TinyTapeout/tinytapeout-mpw7/spi/lvs/user_project_wrapper.spice

* NGSPICE file created from user_project_wrapper.ext - technology: sky130B

* Black-box entry subcircuit for scan_wrapper_341802448429515346 abstract view
.subckt scan_wrapper_341802448429515346 clk_in clk_out data_in data_out latch_enable_in
+ latch_enable_out scan_select_in scan_select_out vccd1 vssd1
.ends

* Black-box entry subcircuit for scan_wrapper_341262321634509394 abstract view
.subckt scan_wrapper_341262321634509394 clk_in clk_out data_in data_out latch_enable_in
+ latch_enable_out scan_select_in scan_select_out vccd1 vssd1
.ends

* Black-box entry subcircuit for scan_wrapper_341243232292700755 abstract view
.subckt scan_wrapper_341243232292700755 clk_in clk_out data_in data_out latch_enable_in
+ latch_enable_out scan_select_in scan_select_out vccd1 vssd1
.ends

* Black-box entry subcircuit for scan_wrapper_339501025136214612 abstract view
.subckt scan_wrapper_339501025136214612 clk_in clk_out data_in data_out latch_enable_in
+ latch_enable_out scan_select_in scan_select_out vccd1 vssd1
.ends

* Black-box entry subcircuit for scan_wrapper_1f985e14df1ed789231bb6e0189d6e39 abstract view
.subckt scan_wrapper_1f985e14df1ed789231bb6e0189d6e39 clk_in clk_out data_in data_out
+ latch_enable_in latch_enable_out scan_select_in scan_select_out vccd1 vssd1
.ends

* Black-box entry subcircuit for scan_wrapper_341524192738411090 abstract view
.subckt scan_wrapper_341524192738411090 clk_in clk_out data_in data_out latch_enable_in
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
.ends

* Black-box entry subcircuit for scan_wrapper_340218629792465491 abstract view
.subckt scan_wrapper_340218629792465491 clk_in clk_out data_in data_out latch_enable_in
+ latch_enable_out scan_select_in scan_select_out vccd1 vssd1
.ends

* Black-box entry subcircuit for scan_wrapper_341608297106768466 abstract view
.subckt scan_wrapper_341608297106768466 clk_in clk_out data_in data_out latch_enable_in
+ latch_enable_out scan_select_in scan_select_out vccd1 vssd1
.ends

* Black-box entry subcircuit for scan_wrapper_341569483755749970 abstract view
.subckt scan_wrapper_341569483755749970 clk_in clk_out data_in data_out latch_enable_in
+ latch_enable_out scan_select_in scan_select_out vccd1 vssd1
.ends

* Black-box entry subcircuit for scan_wrapper_341279123277087315 abstract view
.subckt scan_wrapper_341279123277087315 clk_in clk_out data_in data_out latch_enable_in
+ latch_enable_out scan_select_in scan_select_out vccd1 vssd1
.ends

* Black-box entry subcircuit for scan_wrapper_341353780122485332 abstract view
.subckt scan_wrapper_341353780122485332 clk_in clk_out data_in data_out latch_enable_in
+ latch_enable_out scan_select_in scan_select_out vccd1 vssd1
.ends

* Black-box entry subcircuit for scan_wrapper_341631644820570706 abstract view
.subckt scan_wrapper_341631644820570706 clk_in clk_out data_in data_out latch_enable_in
+ latch_enable_out scan_select_in scan_select_out vccd1 vssd1
.ends

* Black-box entry subcircuit for scan_wrapper_341624400621077076 abstract view
.subckt scan_wrapper_341624400621077076 clk_in clk_out data_in data_out latch_enable_in
+ latch_enable_out scan_select_in scan_select_out vccd1 vssd1
.ends
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
