TinyTapeout/tinytapeout-mpw7/verilog/gl/user_project_wrapper.v

module user_project_wrapper (user_clock2,
    vccd1,
    vccd2,
    vdda1,
    vdda2,
    vssa1,
    vssa2,
    vssd1,
    vssd2,
    wb_clk_i,
    wb_rst_i,
    wbs_ack_o,
    wbs_cyc_i,
    wbs_stb_i,
    wbs_we_i,
    analog_io,
    io_in,
    io_oeb,
    io_out,
    la_data_in,
    la_data_out,
    la_oenb,
    user_irq,
    wbs_adr_i,
    wbs_dat_i,
    wbs_dat_o,
    wbs_sel_i);
 input user_clock2;
 input vccd1;
 input vccd2;
 input vdda1;
 input vdda2;
 input vssa1;
 input vssa2;
 input vssd1;
 input vssd2;
 input wb_clk_i;
 input wb_rst_i;
 output wbs_ack_o;
 input wbs_cyc_i;
 input wbs_stb_i;
 input wbs_we_i;
 inout [28:0] analog_io;
 input [37:0] io_in;
 output [37:0] io_oeb;
 output [37:0] io_out;
 input [127:0] la_data_in;
 output [127:0] la_data_out;
 input [127:0] la_oenb;
 output [2:0] user_irq;
 input [31:0] wbs_adr_i;
 input [31:0] wbs_dat_i;
 output [31:0] wbs_dat_o;
 input [3:0] wbs_sel_i;

 wire \clk[0] ;
 wire \clk[100] ;
 wire \clk[101] ;
 wire \clk[102] ;
 wire \clk[103] ;
 wire \clk[104] ;
 wire \clk[105] ;
 wire \clk[106] ;
 wire \clk[107] ;
 wire \clk[108] ;
 wire \clk[109] ;
 wire \clk[10] ;
 wire \clk[110] ;
 wire \clk[111] ;
 wire \clk[112] ;
 wire \clk[113] ;
 wire \clk[114] ;
 wire \clk[115] ;
 wire \clk[116] ;
 wire \clk[117] ;
 wire \clk[118] ;
 wire \clk[119] ;
 wire \clk[11] ;
 wire \clk[120] ;
 wire \clk[121] ;
 wire \clk[122] ;
 wire \clk[123] ;
 wire \clk[124] ;
 wire \clk[125] ;
 wire \clk[126] ;
 wire \clk[127] ;
 wire \clk[128] ;
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
 wire \scan[86] ;
 wire \scan[87] ;
 wire \scan[88] ;
 wire \scan[89] ;
 wire \scan[8] ;
 wire \scan[90] ;
 wire \scan[91] ;
 wire \scan[92] ;
 wire \scan[93] ;
 wire \scan[94] ;
 wire \scan[95] ;
 wire \scan[96] ;
 wire \scan[97] ;
 wire \scan[98] ;
 wire \scan[99] ;
 wire \scan[9] ;

 scan_controller scan_controller (.clk(wb_clk_i),
    .la_scan_clk_in(la_data_in[0]),
    .la_scan_data_in(la_data_in[1]),
    .la_scan_data_out(la_data_out[0]),
    .la_scan_latch_en(la_data_in[3]),
    .la_scan_select(la_data_in[2]),
    .ready(io_out[37]),
    .reset(wb_rst_i),
    .scan_clk_in(\clk[498] ),
    .scan_clk_out(\clk[0] ),
    .scan_data_in(\data[498] ),
    .scan_data_out(\data[0] ),
    .scan_latch_en(\latch[0] ),
    .scan_select(\scan[0] ),
    .set_clk_div(io_in[11]),
    .slow_clk(io_out[10]),
    .vccd1(vccd1),
    .vssd1(vssd1),
    .active_select({io_in[20],
    io_in[19],
    io_in[18],
    io_in[17],
    io_in[16],
    io_in[15],
    io_in[14],
    io_in[13],
    io_in[12]}),
    .driver_sel({io_in[9],
    io_in[8]}),
    .inputs({io_in[28],
    io_in[27],
    io_in[26],
    io_in[25],
    io_in[24],
    io_in[23],
    io_in[22],
    io_in[21]}),
    .oeb({io_oeb[37],
    io_oeb[36],
    io_oeb[35],
    io_oeb[34],
    io_oeb[33],
    io_oeb[32],
    io_oeb[31],
    io_oeb[30],
    io_oeb[29],
    io_oeb[28],
    io_oeb[27],
    io_oeb[26],
    io_oeb[25],
    io_oeb[24],
    io_oeb[23],
    io_oeb[22],
    io_oeb[21],
    io_oeb[20],
    io_oeb[19],
    io_oeb[18],
    io_oeb[17],
    io_oeb[16],
    io_oeb[15],
    io_oeb[14],
    io_oeb[13],
    io_oeb[12],
    io_oeb[11],
    io_oeb[10],
    io_oeb[9],
    io_oeb[8],
    io_oeb[7],
    io_oeb[6],
    io_oeb[5],
    io_oeb[4],
    io_oeb[3],
    io_oeb[2],
    io_oeb[1],
    io_oeb[0]}),
    .outputs({io_out[36],
    io_out[35],
    io_out[34],
    io_out[33],
    io_out[32],
    io_out[31],
    io_out[30],
    io_out[29]}));
 scan_wrapper_019235602376235615 scan_wrapper_019235602376235615_77 (.clk_in(\clk[77] ),
    .clk_out(\clk[78] ),
    .data_in(\data[77] ),
    .data_out(\data[78] ),
    .latch_enable_in(\latch[77] ),
    .latch_enable_out(\latch[78] ),
    .scan_select_in(\scan[77] ),
    .scan_select_out(\scan[78] ),
    .vccd1(vccd1),
    .vssd1(vssd1));
 scan_wrapper_1f985e14df1ed789231bb6e0189d6e39 scan_wrapper_1f985e14df1ed789231bb6e0189d6e39_44 (.clk_in(\clk[44] ),
    .clk_out(\clk[45] ),
    .data_in(\data[44] ),
    .data_out(\data[45] ),
    .latch_enable_in(\latch[44] ),
    .latch_enable_out(\latch[45] ),
    .scan_select_in(\scan[44] ),
    .scan_select_out(\scan[45] ),
    .vccd1(vccd1),
    .vssd1(vssd1));
 scan_wrapper_339501025136214612 scan_wrapper_339501025136214612_0 (.clk_in(\clk[0] ),
    .clk_out(\clk[1] ),
    .data_in(\data[0] ),
    .data_out(\data[1] ),
    .latch_enable_in(\latch[0] ),
    .latch_enable_out(\latch[1] ),
    .scan_select_in(\scan[0] ),
    .scan_select_out(\scan[1] ),
    .vccd1(vccd1),
    .vssd1(vssd1));
 scan_wrapper_339501025136214612 scan_wrapper_339501025136214612_152 (.clk_in(\clk[152] ),
    .clk_out(\clk[153] ),
    .data_in(\data[152] ),
    .data_out(\data[153] ),
    .latch_enable_in(\latch[152] ),
    .latch_enable_out(\latch[153] ),
    .scan_select_in(\scan[152] ),
    .scan_select_out(\scan[153] ),
    .vccd1(vccd1),
    .vssd1(vssd1));
 scan_wrapper_339501025136214612 scan_wrapper_339501025136214612_153 (.clk_in(\clk[153] ),
    .clk_out(\clk[154] ),
    .data_in(\data[153] ),
    .data_out(\data[154] ),
    .latch_enable_in(\latch[153] ),
    .latch_enable_out(\latch[154] ),
    .scan_select_in(\scan[153] ),
    .scan_select_out(\scan[154] ),
    .vccd1(vccd1),
    .vssd1(vssd1));
 scan_wrapper_339501025136214612 scan_wrapper_339501025136214612_154 (.clk_in(\clk[154] ),
    .clk_out(\clk[155] ),
    .data_in(\data[154] ),
    .data_out(\data[155] ),
    .latch_enable_in(\latch[154] ),
    .latch_enable_out(\latch[155] ),
    .scan_select_in(\scan[154] ),
    .scan_select_out(\scan[155] ),
    .vccd1(vccd1),
    .vssd1(vssd1));
 scan_wrapper_339501025136214612 scan_wrapper_339501025136214612_155 (.clk_in(\clk[155] ),
    .clk_out(\clk[156] ),
    .data_in(\data[155] ),
    .data_out(\data[156] ),
    .latch_enable_in(\latch[155] ),
    .latch_enable_out(\latch[156] ),
    .scan_select_in(\scan[155] ),
    .scan_select_out(\scan[156] ),
    .vccd1(vccd1),
    .vssd1(vssd1));
 scan_wrapper_339501025136214612 scan_wrapper_339501025136214612_156 (.clk_in(\clk[156] ),
    .clk_out(\clk[157] ),
    .data_in(\data[156] ),
    .data_out(\data[157] ),
    .latch_enable_in(\latch[156] ),
    .latch_enable_out(\latch[157] ),
    .scan_select_in(\scan[156] ),
    .scan_select_out(\scan[157] ),
    .vccd1(vccd1),
    .vssd1(vssd1));
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
    .latch_enable_out(\latch[372] ),
    .scan_select_in(\scan[371] ),
    .scan_select_out(\scan[372] ),
    .vccd1(vccd1),
    .vssd1(vssd1));
 scan_wrapper_339501025136214612 scan_wrapper_339501025136214612_372 (.clk_in(\clk[372] ),
    .clk_out(\clk[373] ),
    .data_in(\data[372] ),
    .data_out(\data[373] ),
    .latch_enable_in(\latch[372] ),
    .latch_enable_out(\latch[373] ),
    .scan_select_in(\scan[372] ),
    .scan_select_out(\scan[373] ),
    .vccd1(vccd1),
    .vssd1(vssd1));
 scan_wrapper_339501025136214612 scan_wrapper_339501025136214612_373 (.clk_in(\clk[373] ),
    .clk_out(\clk[374] ),
    .data_in(\data[373] ),
    .data_out(\data[374] ),
    .latch_enable_in(\latch[373] ),
    .latch_enable_out(\latch[374] ),
    .scan_select_in(\scan[373] ),
    .scan_select_out(\scan[374] ),
    .vccd1(vccd1),
    .vssd1(vssd1));
 scan_wrapper_339501025136214612 scan_wrapper_339501025136214612_374 (.clk_in(\clk[374] ),
    .clk_out(\clk[375] ),
    .data_in(\data[374] ),
    .data_out(\data[375] ),
    .latch_enable_in(\latch[374] ),
    .latch_enable_out(\latch[375] ),
    .scan_select_in(\scan[374] ),
    .scan_select_out(\scan[375] ),
    .vccd1(vccd1),
    .vssd1(vssd1));
 scan_wrapper_339501025136214612 scan_wrapper_339501025136214612_375 (.clk_in(\clk[375] ),
    .clk_out(\clk[376] ),
    .data_in(\data[375] ),
    .data_out(\data[376] ),
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
