TinyTapeout/tinytapeout-mpw7/verilog/rtl/user_module_341717091617866324.v

`default_nettype none

module utm_core_341717091617866324(
    input clock,
    input reset,
    input mode,
    input [2:0] encoded_state_in,
    input [2:0] sym_in,
    input sym_in_valid,
    output [2:0] new_sym,
    output direction,
    output [2:0] encoded_next_state
);

reg [7:0] stored_state;
reg [2:0] symbuf;
reg symbuf_valid;

wire [7:0] state_in;
wire [7:0] state;
wire [7:0] next_state;
wire [2:0] sym;

always @(posedge clock) begin
    if (reset) begin
        stored_state <= 8'h01;
    end
    else if (sym_in_valid && symbuf_valid) begin
        stored_state <= next_state;
    end
    else begin
        stored_state <= stored_state;
    end
end

always @(posedge clock) begin
    if (reset) begin
        symbuf <= 3'b0;
    end
    else if (sym_in_valid) begin
        symbuf <= sym_in;
    end
    else begin
        symbuf <= symbuf;
    end
end

always @(posedge clock) begin
    if (reset) begin
        symbuf_valid <= 0;
    end
    else if (sym_in_valid) begin
        symbuf_valid <= 1;
    end
    else begin
        symbuf_valid <= symbuf_valid;
    end
end

decoder_3to8_341717091617866324 decode_state_in(
    .in(encoded_state_in),
    .out(state_in)
);

assign state = (mode == 0) ? state_in : stored_state;
assign sym = (mode == 0) ? sym_in : symbuf;

direction_341717091617866324 direction_block(
    .state(state),
    .s2(sym[2]),
    .s1(sym[1]),
    .s0(sym[0]),
    .direction(direction)
);

next_state_341717091617866324 next_state_block(
    .state_in(state),
    .s2(sym[2]),
    .s1(sym[1]),
    .s0(sym[0]),
    .state_out(next_state));

new_symbol_341717091617866324 new_sym_block(
    .state_in(state),
    .s2(sym[2]),
    .s1(sym[1]),
    .s0(sym[0]),
    .z2(new_sym[2]),
    .z1(new_sym[1]),
    .z0(new_sym[0])
);

encoder_8to3_341717091617866324 encode_state_out(
    .in(next_state),
    .out(encoded_next_state)
);

endmodule
`default_nettype none
module direction_341717091617866324(
    input [7:0] state,
    input s2,
    input s1,
    input s0,
    // 0 = left, 1 = right
    output direction
);

wire [7:0] state_in;
assign state_in = state;

wire [2:0] sym_in;
assign sym_in = {s2, s1, s0};

reg dir;
assign direction = dir;

always @(*) begin
    /* verilator lint_off CASEINCOMPLETE */
    case (state_in)
        8'h01: begin
            case (sym_in)
            3'b000: begin
                dir = 0;
            end
            3'b001: begin
                dir = 0;
            end
            3'b010: begin
                dir = 1;
            end
            3'b100: begin
                dir = 0;
            end
            3'b101: begin
                dir = 1;
            end
            3'b110: begin
                dir = 1;
            end
            3'b111: begin
                dir = 1;
            end
            endcase
        end
        8'h02: begin
            case (sym_in)
            3'b000: begin
                dir = 0;
            end
            3'b001: begin
                dir = 0;
            end
            3'b010: begin
                dir = 0;
            end
            3'b100: begin
                dir = 1;
            end
            3'b101: begin
                dir = 1;
            end
            3'b110: begin
                dir = 0;
            end
            3'b111: begin
                dir = 0;
            end
            endcase
        end
        8'h04: begin
            case (sym_in)
            3'b000: begin
                dir = 0;
            end
            3'b001: begin
                dir = 0;
            end
            3'b010: begin
                dir = 0;
            end
            3'b100: begin
                dir = 1;
            end
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
assign out[4] = ( in[2]) & (~in[1]) & (~in[0]);
assign out[5] = ( in[2]) & (~in[1]) & ( in[0]);
assign out[6] = ( in[2]) & ( in[1]) & (~in[0]);
assign out[7] = ( in[2]) & ( in[1]) & ( in[0]);

endmodule
module encoder_8to3_341717091617866324(
    input [7:0] in,
    output [2:0] out
);

assign out[0] = in[1] | in[3] | in[5] | in[7];
assign out[1] = in[2] | in[3] | in[6] | in[7];
assign out[2] = in[4] | in[5] | in[6] | in[7];
endmodule
`default_nettype none

module user_module_341717091617866324(
  input [7:0] io_in,
  output [7:0] io_out
);

wire mode;
wire clock;
wire reset;

wire direction;

wire sym_valid;
wire [2:0] sym_in;
wire [2:0] new_sym;

// 1-hot state in & out
wire [7:0] state_in;
wire [7:0] state_out;

// 3-bit dense encoding of state in & out
wire [2:0] encoded_state_in;
wire [2:0] encoded_state_out;

assign mode = io_in[7];
assign clock = io_in[0];
assign reset = (mode == 0) ? 1'b1 : io_in[1];

assign encoded_state_in = (mode == 0) ? io_in[3:1] : 3'b0;
assign io_out[7:5] = encoded_state_out;

assign sym_valid = (mode == 0) ? 1'b0 : io_in[2];
assign sym_in = io_in[6:4];
assign io_out[4:2] = new_sym;

assign io_out[1] = direction;
assign io_out[0] = 1'b0;

utm_core_341717091617866324 core(
    .clock(clock),
    .reset(reset),
    .mode(mode),
    .encoded_state_in(encoded_state_in),
    .sym_in(sym_in),
    .sym_in_valid(sym_valid),
    .new_sym(new_sym),
    .direction(direction),
    .encoded_next_state(encoded_state_out)
);

endmodule
