TinyTapeout/tinytapeout-mpw7/verilog/rtl/user_project_wrapper.v

// SPDX-FileCopyrightText: 2020 Efabless Corporation
//
// Licensed under the Apache License, Version 2.0 (the "License");
// you may not use this file except in compliance with the License.
// You may obtain a copy of the License at
//
//      http://www.apache.org/licenses/LICENSE-2.0
//
// Unless required by applicable law or agreed to in writing, software
// distributed under the License is distributed on an "AS IS" BASIS,
// WITHOUT WARRANTIES OR CONDITIONS OF ANY KIND, either express or implied.
// See the License for the specific language governing permissions and
// limitations under the License.
// SPDX-License-Identifier: Apache-2.0

`default_nettype none
/*
 *-------------------------------------------------------------
 *
 * user_project_wrapper
 *
 * This wrapper enumerates all of the pins available to the
 * user for the user project.
 *
 * An example user project is provided in this wrapper.  The
 * example should be removed and replaced with the actual
 * user project.
 *
 * THIS FILE HAS BEEN GENERATED USING multi_tools_project CODEGEN
 * IF YOU NEED TO MAKE EDITS TO IT, EDIT codegen/caravel_iface_header.txt
 *
 *-------------------------------------------------------------
 */

module user_project_wrapper #(
    parameter BITS = 32
)(
`ifdef USE_POWER_PINS
    inout vdda1,       // User area 1 3.3V supply
    inout vdda2,       // User area 2 3.3V supply
    inout vssa1,       // User area 1 analog ground
    inout vssa2,       // User area 2 analog ground
    inout vccd1,       // User area 1 1.8V supply
    inout vccd2,       // User area 2 1.8v supply
    inout vssd1,       // User area 1 digital ground
    inout vssd2,       // User area 2 digital ground
`endif

    // Wishbone Slave ports (WB MI A)
    input wb_clk_i,
    input wb_rst_i,
    input wbs_stb_i,
    input wbs_cyc_i,
    input wbs_we_i,
    input [3:0] wbs_sel_i,
    input [31:0] wbs_dat_i,
    input [31:0] wbs_adr_i,
    output wbs_ack_o,
    output [31:0] wbs_dat_o,

    // Logic Analyzer Signals
    input  [127:0] la_data_in,
    output [127:0] la_data_out,
    input  [127:0] la_oenb,

    // IOs
    input  [`MPRJ_IO_PADS-1:0] io_in,
    output [`MPRJ_IO_PADS-1:0] io_out,
    output [`MPRJ_IO_PADS-1:0] io_oeb,

    // Analog (direct connection to GPIO pad---use with caution)
    // Note that analog I/O is not available on the 7 lowest-numbered
    // GPIO pads, and so the analog_io indexing is offset from the
    // GPIO indexing by 7 (also upper 2 GPIOs do not have analog_io).
    inout [`MPRJ_IO_PADS-10:0] analog_io,

    // Independent clock (on independent integer divider)
    input   user_clock2,

    // User maskable interrupt signals
    output [2:0] user_irq
);

    // start of module instantiation

        localparam NUM_MACROS = 498;
        wire [NUM_MACROS:0] data, scan, latch, clk;
        
        scan_controller #(.NUM_DESIGNS(NUM_MACROS)) scan_controller(
            .clk                    (wb_clk_i),
            .reset                  (wb_rst_i),
            .active_select          (io_in[20:12]),
            .inputs                 (io_in[28:21]),
            .outputs                (io_out[36:29]),
            .ready                  (io_out[37]),
            .slow_clk               (io_out[10]),
            .set_clk_div            (io_in[11]),

            .scan_clk_out           (clk[0]),
            .scan_clk_in            (clk[NUM_MACROS]),
            .scan_data_out          (data[0]),
            .scan_data_in           (data[NUM_MACROS]),
            .scan_select            (scan[0]),
            .scan_latch_en          (latch[0]),

            .la_scan_clk_in         (la_data_in[0]),
            .la_scan_data_in        (la_data_in[1]),
            .la_scan_data_out       (la_data_out[0]),
            .la_scan_select         (la_data_in[2]),
            .la_scan_latch_en       (la_data_in[3]),

            .driver_sel             (io_in[9:8]),

            .oeb                    (io_oeb)
        );

        
        // https://github.com/mattvenn/wokwi_filler
        scan_wrapper_339501025136214612 #(.NUM_IOS(8)) scan_wrapper_339501025136214612_0 (
            .clk_in          (clk  [0]),
            .data_in         (data [0]),
            .scan_select_in  (scan [0]),
            .latch_enable_in (latch[0]),
            .clk_out         (clk  [1]),
            .data_out        (data [1]),
            .scan_select_out (scan [1]),
            .latch_enable_out(latch[1])
            );
        
        // https://github.com/mattvenn/tinytapeout_m_segments
        scan_wrapper_339688086163161683 #(.NUM_IOS(8)) scan_wrapper_339688086163161683_1 (
            .clk_in          (clk  [1]),
            .data_in         (data [1]),
            .scan_select_in  (scan [1]),
            .latch_enable_in (latch[1]),
            .clk_out         (clk  [2]),
            .data_out        (data [2]),
            .scan_select_out (scan [2]),
            .latch_enable_out(latch[2])
            );
        
        // https://github.com/gregdavill/tinytapeout_spin0
        scan_wrapper_340218629792465491 #(.NUM_IOS(8)) scan_wrapper_340218629792465491_2 (
            .clk_in          (clk  [2]),
            .data_in         (data [2]),
            .scan_select_in  (scan [2]),
            .latch_enable_in (latch[2]),
            .clk_out         (clk  [3]),
            .data_out        (data [3]),
            .scan_select_out (scan [3]),
            .latch_enable_out(latch[3])
            );
        
        // https://github.com/mole99/wokwi-1bit-alu
        scan_wrapper_340318610245288530 #(.NUM_IOS(8)) scan_wrapper_340318610245288530_3 (
            .clk_in          (clk  [3]),
            .data_in         (data [3]),
            .scan_select_in  (scan [3]),
            .latch_enable_in (latch[3]),
            .clk_out         (clk  [4]),
            .data_out        (data [4]),
            .scan_select_out (scan [4]),
            .latch_enable_out(latch[4])
            );
        
        // https://github.com/ericsmi/tinytapeout_popcnt.git
        scan_wrapper_340285391309374034 #(.NUM_IOS(8)) scan_wrapper_340285391309374034_4 (
            .clk_in          (clk  [4]),
            .data_in         (data [4]),
            .scan_select_in  (scan [4]),
            .latch_enable_in (latch[4]),
            .clk_out         (clk  [5]),
            .data_out        (data [5]),
            .scan_select_out (scan [5]),
            .latch_enable_out(latch[5])
            );
        
        // https://github.com/krasin/wokwi-guess-my-number
        scan_wrapper_340661930553246290 #(.NUM_IOS(8)) scan_wrapper_340661930553246290_5 (
            .clk_in          (clk  [5]),
            .data_in         (data [5]),
            .scan_select_in  (scan [5]),
            .latch_enable_in (latch[5]),
            .clk_out         (clk  [6]),
            .data_out        (data [6]),
            .scan_select_out (scan [6]),
            .latch_enable_out(latch[6])
            );
        
        // https://github.com/johshoff/barrelshifter-wokwi-gds
        scan_wrapper_341136771628663380 #(.NUM_IOS(8)) scan_wrapper_341136771628663380_6 (
            .clk_in          (clk  [6]),
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
            .latch_enable_in (latch[222]),
            .clk_out         (clk  [223]),
            .data_out        (data [223]),
            .scan_select_out (scan [223]),
            .latch_enable_out(latch[223])
            );
        
        // https://github.com/mattvenn/wokwi_filler
        scan_wrapper_339501025136214612 #(.NUM_IOS(8)) scan_wrapper_339501025136214612_223 (
            .clk_in          (clk  [223]),
            .data_in         (data [223]),
            .scan_select_in  (scan [223]),
            .latch_enable_in (latch[223]),
            .clk_out         (clk  [224]),
            .data_out        (data [224]),
            .scan_select_out (scan [224]),
            .latch_enable_out(latch[224])
            );
        
        // https://github.com/mattvenn/wokwi_filler
        scan_wrapper_339501025136214612 #(.NUM_IOS(8)) scan_wrapper_339501025136214612_224 (
            .clk_in          (clk  [224]),
            .data_in         (data [224]),
            .scan_select_in  (scan [224]),
            .latch_enable_in (latch[224]),
            .clk_out         (clk  [225]),
            .data_out        (data [225]),
            .scan_select_out (scan [225]),
            .latch_enable_out(latch[225])
            );
        
        // https://github.com/mattvenn/wokwi_filler
        scan_wrapper_339501025136214612 #(.NUM_IOS(8)) scan_wrapper_339501025136214612_225 (
            .clk_in          (clk  [225]),
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
