TinyTapeout/tinytapeout-mpw7/verilog/rtl/user_module_341542971476279892.v

`default_nettype none

//  Top level io for this module should stay the same to fit into the scan_wrapper.
//  The pin connections within the user_module are up to you,
//  although (if one is present) it is recommended to place a clock on io_in[0].
//  This allows use of the internal clock divider if you wish.
module user_module_341542971476279892(
  input [7:0] io_in, 
  output [7:0] io_out
);

  logo_341542971476279892 logo(
    .clk(io_in[0]),    
    .reset(io_in[1]),

    .tx_out(io_out[0])
  );

endmodule

//  Any submodules should be included in this file,
//  so they are copied into the main TinyTapeout repo.
//  Appending your ID to any submodules you create 
//  ensures there are no clashes in full-chip simulation.

module logo_341542971476279892 (
    input clk,
    input reset,
    
    output reg tx_out
  );

  reg       [7:0] rle_segment_counter;
  reg       [7:0] rle_pixel_counter;
  reg             rle_pixel_state;

  reg       [7:0] line_pixel_counter; //0 to IMG_WIDTH-1, pixels within a line

  reg       [7:0] next_rle_segment_counter;
  reg       [7:0] next_rle_pixel_counter;
  reg             next_rle_pixel_state;

  reg       [7:0] next_line_pixel_counter;

  reg       [7:0] current_rle_length; //length of current segment
  reg       [7:0] current_rle_n_segments; //number of segments in image
  
  reg             start_pixel;
  reg       [7:0] img_width; //max 255 with 8 bits

  //picture data

  parameter LEN_lambdaRLE = 207;
  parameter WIDTH_lambdaRLE = 41;
  parameter START_lambdaRLE = 1;
  wire [7:0] lambdaRLE [0:LEN_lambdaRLE-1]; //Lambda symbol
  
  assign lambdaRLE[0] = 41; assign lambdaRLE[1] = 136; assign lambdaRLE[2] = 3; assign lambdaRLE[3] = 9; assign lambdaRLE[4] = 3; assign lambdaRLE[5] = 26; assign lambdaRLE[6] = 3; assign lambdaRLE[7] = 9; assign lambdaRLE[8] = 3; assign lambdaRLE[9] = 26; assign lambdaRLE[10] = 3; assign lambdaRLE[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

  always @(posedge clk) begin
    if (reset) begin
      rle_segment_counter <= 0;
      rle_pixel_counter   <= 0;
      rle_pixel_state     <= start_pixel;

      line_pixel_counter  <= 0;
    end else begin
      rle_segment_counter <= next_rle_segment_counter;
      rle_pixel_counter <= next_rle_pixel_counter;
      rle_pixel_state <= next_rle_pixel_state;

      line_pixel_counter <= next_line_pixel_counter;
    end
  end

  always @(*) begin
    next_rle_segment_counter = rle_segment_counter;
    next_rle_pixel_counter = rle_pixel_counter;
    next_rle_pixel_state = rle_pixel_state;

    next_line_pixel_counter = line_pixel_counter;

    current_rle_length     = lambdaRLE[rle_segment_counter];
    current_rle_n_segments = LEN_lambdaRLE;
    start_pixel = START_lambdaRLE;
    img_width = WIDTH_lambdaRLE;
    
    if(rle_pixel_counter < current_rle_length-1) begin
      next_rle_pixel_counter = rle_pixel_counter + 1;
    end else begin
      next_rle_pixel_counter = 0;
      next_rle_pixel_state = !rle_pixel_state;

      if(rle_segment_counter < current_rle_n_segments-1) begin
        next_rle_segment_counter = rle_segment_counter + 1;
      end else begin
        next_rle_segment_counter = 0;
        next_rle_pixel_state = start_pixel;
        next_line_pixel_counter = 0;
      end
    end

    tx_out = rle_pixel_state;
  end


endmodule
