TinyTapeout/tinytapeout-mpw7/verilog/rtl/user_project_includes.v

`include "scan_controller/scan_controller.v"
`include "scan_wrapper_339501025136214612.v"
`include "scan_wrapper_339688086163161683.v"
`include "scan_wrapper_340218629792465491.v"
`include "scan_wrapper_340318610245288530.v"
`include "scan_wrapper_340285391309374034.v"
`include "scan_wrapper_340661930553246290.v"
`include "scan_wrapper_341136771628663380.v"
`include "scan_wrapper_339800239192932947.v"
`include "scan_wrapper_341154161238213203.v"
`include "scan_wrapper_341159915403870803.v"
`include "scan_wrapper_341154068332282450.v"
`include "scan_wrapper_341160201697624660.v"
`include "scan_wrapper_341163800289870419.v"
`include "scan_wrapper_341160271679586899.v"
`include "scan_wrapper_341161378978988626.v"
`include "scan_wrapper_341152580068442706.v"
`include "scan_wrapper_341155178824598098.v"
`include "scan_wrapper_341167691532337747.v"
`include "scan_wrapper_341178154799333971.v"
`include "scan_wrapper_341178481588044372.v"
`include "scan_wrapper_341176884318437971.v"
`include "scan_wrapper_341182944314917460.v"
`include "scan_wrapper_341188777753969234.v"
`include "scan_wrapper_341194143598379604.v"
`include "scan_wrapper_341205508016833108.v"
`include "scan_wrapper_341162950004834900.v"
`include "scan_wrapper_341202178192441940.v"
`include "scan_wrapper_341191836498395731.v"
`include "scan_wrapper_341192113929585235.v"
`include "scan_wrapper_341192621088047698.v"
`include "scan_wrapper_340579111348994642.v"
`include "scan_wrapper_341224613878956628.v"
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
`include "scan_wrapper_341490465660469844.v"
`include "scan_wrapper_341581732833657427.v"
`include "scan_wrapper_341457494561784402.v"
`include "scan_wrapper_341590933015364178.v"
`include "scan_wrapper_341589685194195540.v"
`include "scan_wrapper_341608574336631379.v"
`include "scan_wrapper_341608297106768466.v"
`include "scan_wrapper_341802448429515346.v"
`include "scan_wrapper_341609034095264340.v"
`include "scan_wrapper_341617722294010450.v"
`include "scan_wrapper_341613097060926036.v"
`include "scan_wrapper_341614346808328788.v"
`include "scan_wrapper_341620484740219475.v"
`include "scan_wrapper_341624400621077076.v"
`include "scan_wrapper_341614536664547922.v"
`include "scan_wrapper_341567111632519764.v"
`include "scan_wrapper_3398002391929329472.v"
`include "scan_wrapper_341631485498884690.v"
`include "scan_wrapper_341632596577354323.v"
`include "scan_wrapper_341628725785264722.v"
`include "scan_wrapper_341631511790879314.v"
`include "scan_wrapper_341426151397261906.v"
`include "scan_wrapper_341629415144292948.v"
`include "scan_wrapper_341637831098106450.v"
`include "scan_wrapper_341631644820570706.v"
`include "scan_wrapper_340596276030603858.v"
`include "scan_wrapper_341678527574180436.v"
