TinyTapeout/tinytapeout-mpw7/verilog/rtl/user_module_1f985e14df1ed789231bb6e0189d6e39.v

module s_p_shift_reg #(parameter LENGTH=256, parameter ROT_LEN = 8) (input d,
                                          input clk,
                                          input rst_n,
                                          input cs_n,
                                          input rot_n,
                                          output reg [LENGTH-1:0] out);
                                                      
  always @(posedge clk or negedge rst_n)
    begin
      if(!rst_n)
        out <= {LENGTH{1'b0}};
      else if (!cs_n)
        out <= {out[LENGTH-2:0], d};
      else if (!rot_n)
        out <= {out[ROT_LEN -1:0], out[LENGTH -1:ROT_LEN]};
      else 
        out <= out;
    end
  
endmodule

module lut #(parameter IN_WIDTH=4, parameter OUT_WIDTH=4) (input [IN_WIDTH-1:0] sel,
                                                           input [2**(IN_WIDTH)*OUT_WIDTH-1:0] in,
                                                           output [OUT_WIDTH-1:0] out);
 
 
  
  wire [OUT_WIDTH-1:0] chunked_in [2**IN_WIDTH-1:0];
  
  genvar i;
  
  generate
    for (i = 0; i < 2**IN_WIDTH; i = i+1) begin
      assign chunked_in[i] = in[(i+1) * OUT_WIDTH - 1 -: OUT_WIDTH];
    end
  endgenerate	     
  
  assign out = chunked_in[sel];
  
endmodule

module serial_load_lut #(parameter IN_WIDTH=4, parameter OUT_WIDTH=4, parameter ROT_LEN=8) (
  input d, input clk, input rst_n, input cs_n, input rot_n, input [IN_WIDTH-1:0] sel, output [OUT_WIDTH-1:0] out);
  
  wire [2**(IN_WIDTH)*OUT_WIDTH-1:0] parallel_table;
  
  s_p_shift_reg #(2**(IN_WIDTH)*OUT_WIDTH, ROT_LEN) p_s_shift_reg(.d(d),.clk(clk),.rst_n(rst_n),.cs_n(cs_n),
                                                                  .rot_n(rot_n), .out(parallel_table));
  
  lut #(IN_WIDTH, OUT_WIDTH) lut(.sel(sel), .in(parallel_table), .out(out));
  
  
endmodule

module user_module_1f985e14df1ed789231bb6e0189d6e39(
  input [7:0] io_in,
  output [7:0] io_out
);

  serial_load_lut #(2, 8) lut(.d(io_in[0]), .clk(io_in[1]), .rst_n(io_in[2]), .cs_n(io_in[3]), 
                              .rot_n(io_in[6]), .sel(io_in[5:4]), .out(io_out[7:0]));
  
  //assign io_out[7:3] = 0;
  
endmodule
