TinyTapeout/tinytapeout-mpw7/verilog/gl/scan_controller.v

module scan_controller (clk,
    la_scan_clk_in,
    la_scan_data_in,
    la_scan_data_out,
    la_scan_latch_en,
    la_scan_select,
    ready,
    reset,
    scan_clk_in,
    scan_clk_out,
    scan_data_in,
    scan_data_out,
    scan_latch_en,
    scan_select,
    set_clk_div,
    slow_clk,
    vccd1,
    vssd1,
    active_select,
    driver_sel,
    inputs,
    oeb,
    outputs);
 input clk;
 input la_scan_clk_in;
 input la_scan_data_in;
 output la_scan_data_out;
 input la_scan_latch_en;
 input la_scan_select;
 output ready;
 input reset;
 input scan_clk_in;
 output scan_clk_out;
 input scan_data_in;
 output scan_data_out;
 output scan_latch_en;
 output scan_select;
 input set_clk_div;
 output slow_clk;
 input vccd1;
 input vssd1;
 input [8:0] active_select;
 input [1:0] driver_sel;
 input [7:0] inputs;
 output [37:0] oeb;
 output [7:0] outputs;

 wire net44;
 wire net54;
 wire net55;
 wire net56;
 wire net57;
 wire net58;
 wire net59;
 wire net60;
 wire net61;
 wire net62;
 wire net63;
 wire net45;
 wire net64;
 wire net65;
 wire net66;
 wire net67;
 wire net68;
 wire net69;
 wire net70;
 wire net71;
 wire net72;
 wire net73;
 wire net46;
 wire net74;
 wire net75;
 wire net76;
 wire net77;
 wire net78;
 wire net79;
 wire net80;
 wire net81;
 wire net47;
 wire net48;
 wire net49;
 wire net50;
 wire net51;
 wire net52;
 wire net53;
 wire _000_;
 wire _001_;
 wire _002_;
 wire _003_;
 wire _004_;
 wire _005_;
 wire _006_;
 wire _007_;
 wire _008_;
 wire _009_;
 wire _010_;
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
    .VNB(vssd1),
    .VPB(vccd1),
    .VPWR(vccd1));
 sky130_fd_sc_hd__decap_6 FILLER_21_217 (.VGND(vssd1),
    .VNB(vssd1),
    .VPB(vccd1),
    .VPWR(vccd1));
 sky130_fd_sc_hd__fill_1 FILLER_21_223 (.VGND(vssd1),
    .VNB(vssd1),
    .VPB(vccd1),
    .VPWR(vccd1));
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
