TinyTapeout/tinytapeout-mpw7/(commit log)

2022-08-03 manually delete a load of power traces
2022-08-05 updating repo
    [macro.cfg]
2022-08-05 manually added missing power rings
    [scan_wrapper_334445762078310996.v, scan_wrapper_335404063203000914.v, user_project_wrapper.v]
2022-08-05 fix outer power ring width
2022-08-08 try fix PDN with custom pdn_cfg.tcl and use -nets option
    [macro.cfg]
2022-08-08 remove fetch stage
2022-08-09 remove debug print
2022-08-09 update with new designs
    [macro.cfg]
2022-08-17 update designs
    [macro.cfg]
2022-08-23 integrate new projects
    [macro.cfg]
2022-08-25 add 7 segment seconds
    [macro.cfg]
2022-08-27 new design
    [macro.cfg]
2022-08-27 reharden with correct clock port for scan_controller
    [scan_controller.v]
2022-08-27 new designs
    [macro.cfg]
2022-08-28 test logic analyser control of scan chain works
2022-08-28 build index
    [macro.cfg]
2022-08-29 new diesngs
    [macro.cfg]
2022-08-31 add debug switch for getting a single repo, only use GDS named artifacts
2022-09-01 scan_controller: Use negedge for reset sync
    This keeps the reset transition away from the clock edge
    [scan_controller.v]
2022-09-01 switch sel
2022-09-01 ready signal and reset for clock div
    [scan_controller.v]
2022-09-01 remove the reset from clockdiv and update tb to reset so test passes
    [scan_controller.v, test_scan_controller.py]
2022-09-02 fix ext scan test
    [scan_controller.c, scan_controller_tb.v, test_scan_controller.py]
2022-09-02 change scan chain instantiation order
2022-09-02 fixed la test
2022-09-02 update to zigzag layout
    [macro.cfg]
2022-09-03 hardened all submissions
    [macro.cfg]
